piussieber/pjon_on_croc/doc/PJON_on_Croc.png

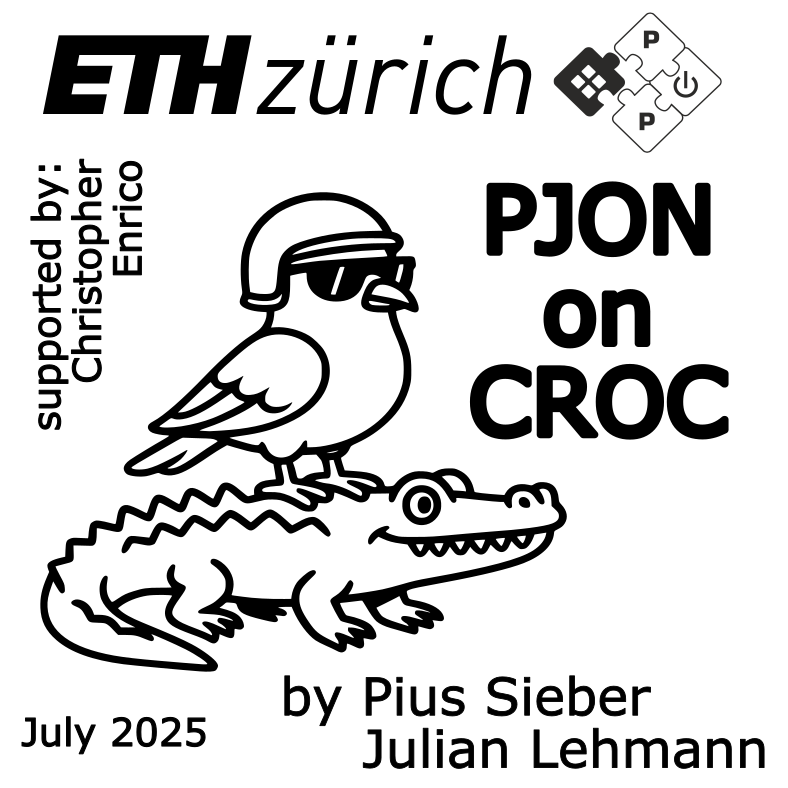
doc/PJON_on_Croc.png
