piussieber/pjon_on_croc/sw/config.h

// Copyright 2022 ETH Zurich and University of Bologna.
// Licensed under the Apache License, Version 2.0, see LICENSE for details.
// SPDX-License-Identifier: Apache-2.0
//
// Nils Wistoff <nwistoff@iis.ee.ethz.ch>
// Paul Scheffler <paulsc@iis.ee.ethz.ch>

#pragma once

// Address map
#define SOCCTRL_BASE_ADDR 0x03000000
#define UART_BASE_ADDR    0x03002000
#define GPIO_BASE_ADDR    0x03005000
#define TIMER_BASE_ADDR   0x0300A000

// Frequencies
#define TB_FREQUENCY 80000000
#define TB_BAUDRATE    115200

// Peripheral configs
// UART
#define UART_BYTE_ALIGN 4
#define UART_FREQ       TB_FREQUENCY
#define UART_BAUD       TB_BAUDRATE
